dmBots/balance_robot/projects/平衡小车/结构/装配/装配说明.jpg

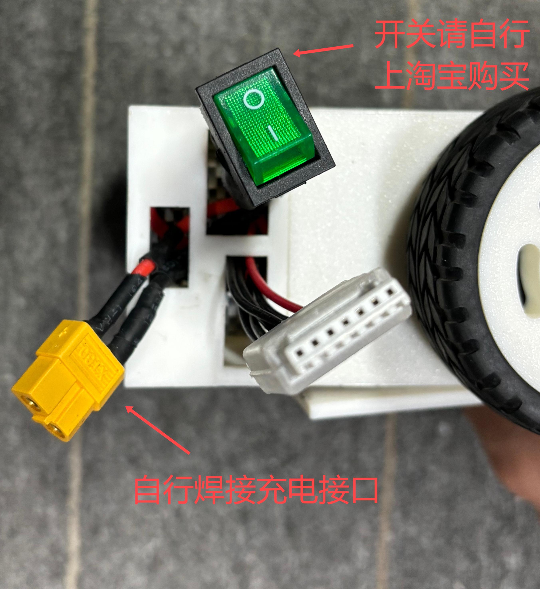
projects/平衡小车/结构/装配/装配说明.jpg
