dmBots/balance_robot/README.md

# balance_robot

English release entry. This repository is maintained from the materials source.
