dmBots/balance_robot/projects/桌面轮足/README.md

# 桌面轮足

#### 介绍
这是达妙科技开源桌面轮足仓库 QQ交流群：680048275 。

桌面轮足硬件方案是达妙STM32H7开发板+两个达妙3510电机+两个达妙3507电机+蓝牙模块。

控制模型都是是一阶倒立摆，控制方法用的是lqr。

如果该项目对您有帮助，可以点点右上角的star。

#### 软件架构

` test `

#### 安装教程

1.  xxxx
2.  xxxx
3.  xxxx

#### 使用说明

1.  xxxx
2.  xxxx
3.  xxxx

#### 参与贡献

1.  Fork 本仓库
2.  新建 Feat_xxx 分支
3.  提交代码
4.  新建 Pull Request

#### 参考

1.  [https://zhuanlan.zhihu.com/p/563048952](https://zhuanlan.zhihu.com/p/563048952)
2.  [https://www.bilibili.com/video/BV1UZ4y1h7u2/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](https://www.bilibili.com/video/BV1UZ4y1h7u2/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)
