dmBots/balance_robot/projects/平衡小车/代码/readme.txt

1、该程序是用lqr控制方法

2、参考文献来源于b站轮腿式机器人开源，连接：https://www.bilibili.com/video/BV1UZ4y1h7u2/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
