dmBots/balance_robot/projects/平衡小车/硬件接线图/平衡小车硬件接线图.png

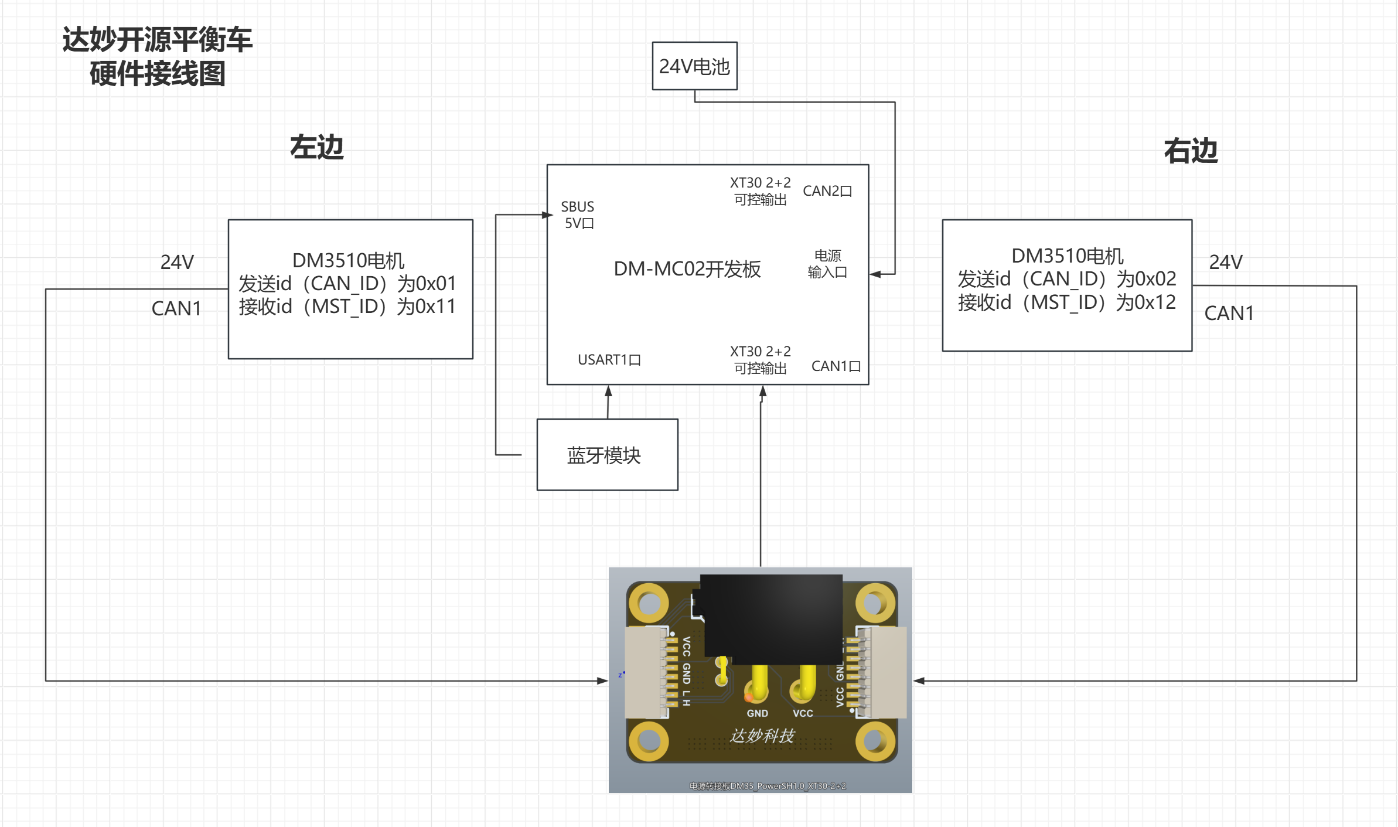
projects/平衡小车/硬件接线图/平衡小车硬件接线图.png
