dmBots/balance_robot/projects/桌面轮足/硬件接线图/达妙桌面轮足硬件接线图.png

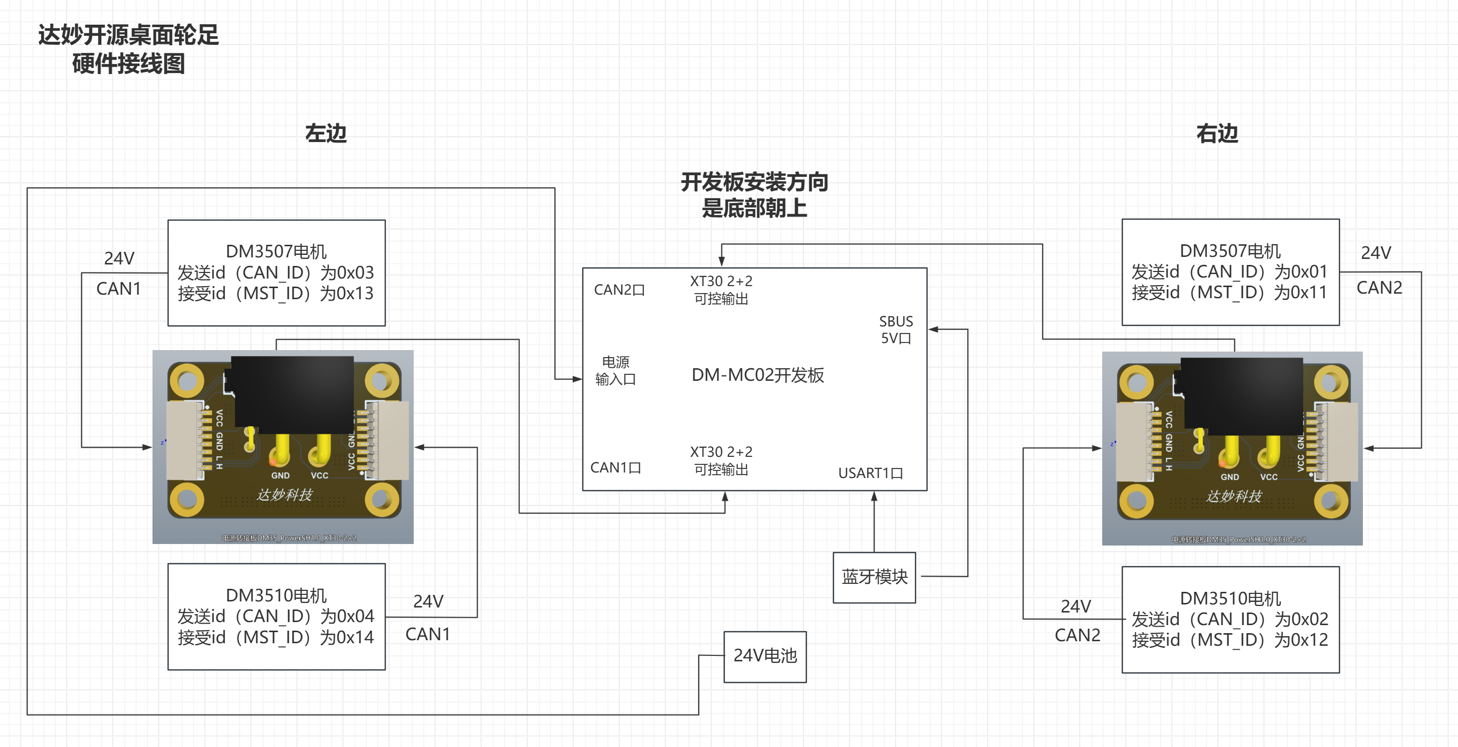
projects/桌面轮足/硬件接线图/达妙桌面轮足硬件接线图.png
