dmBots/balance_robot/projects/桌面轮足/结构/Bom gx2.17.xlsx

购买清单bom表汇总
螺钉螺母 |  |  | 数量 | 用途
沉头螺钉 | https://detail.tmall.com/item.htm?abbucket=4&id=693377485791&rn=86a33738773fb73d30a7dfbeb797c28e | M3*8 | 8 | DM-H3510-1E 固定
沉头螺钉 | https://detail.tmall.com/item.htm?abbucket=4&id=693377485791&rn=86a33738773fb73d30a7dfbeb797c28e | M3*6 | 4 | 前面板固定
沉头螺钉 | https://detail.tmall.com/item.htm?abbucket=4&id=693377485791&rn=86a33738773fb73d30a7dfbeb797c28e | M3*8 | 4 | 上面板固定
沉头螺钉 | https://detail.tmall.com/item.htm?abbucket=4&id=693377485791&rn=86a33738773fb73d30a7dfbeb797c28e | M3*12 | 4 | 限位固定
沉头螺钉 | https://detail.tmall.com/item.htm?abbucket=4&id=693377485791&rn=86a33738773fb73d30a7dfbeb797c28e | M2.5*12 | 6 | dm35_power固定，每个板装三颗 ，详见3d图示
沉头螺钉 | https://detail.tmall.com/item.htm?abbucket=4&id=693377485791&rn=86a33738773fb73d30a7dfbeb797c28e | M3*8 | 4 | 电池仓固定板固定孔
沉头螺钉 | https://detail.tmall.com/item.htm?abbucket=4&id=693377485791&rn=86a33738773fb73d30a7dfbeb797c28e | M3*12 | 6 | 左右轮轮装配
沉头螺钉 | https://detail.tmall.com/item.htm?abbucket=4&id=693377485791&rn=86a33738773fb73d30a7dfbeb797c28e | M3*12 | 6 | 左右轮轮固定
杯头螺栓 | https://detail.tmall.com/item.htm?_u=hkdjgo4a167&id=675935672539 | M3*24 | 4 | 腿左右板固定
沉头螺钉 | https://detail.tmall.com/item.htm?abbucket=4&id=693377485791&rn=86a33738773fb73d30a7dfbeb797c28e | M3*20 | 2 | 腿左右板加强螺丝
沉头螺钉 | https://detail.tmall.com/item.htm?abbucket=4&id=693377485791&rn=86a33738773fb73d30a7dfbeb797c28e | M3*16 | 6 | 大腿固定3510螺丝
对锁螺栓 | https://detail.tmall.com/item.htm?id=775683678140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 | M5*15 | 6 | 这部分固定由于对锁螺丝无法松紧适中 需自我调节螺纹胶固定
热熔螺母 | https://detail.tmall.com/item.htm?abbucket=10&id=673367228604&rn=c2a32b0ae8e4624b2e8f4e8f2e719e3e | M3*4.5*5 | 12
杯头螺栓 | https://detail.tmall.com/item.htm?abbucket=10&id=636175026159&rn=d62e44d01be55868af98aa2eff1e3e44 | M2.5*5 | 5 | 主控板固定
防松螺母 | https://detail.tmall.com/item.htm?id=534828257082&_u=12085qbuhef350 | M3 | 8
防松螺母 | https://detail.tmall.com/item.htm?id=534828257082&_u=12085qbuhef350 | M2.5 | 8
上述螺丝汇总
沉头螺钉 | https://detail.tmall.com/item.htm?abbucket=4&id=693377485791&rn=86a33738773fb73d30a7dfbeb797c28e | M3*8 | 16
沉头螺钉 | https://detail.tmall.com/item.htm?abbucket=4&id=693377485791&rn=86a33738773fb73d30a7dfbeb797c28e | M3*6 | 4
沉头螺钉 | https://detail.tmall.com/item.htm?abbucket=4&id=693377485791&rn=86a33738773fb73d30a7dfbeb797c28e | M3*12 | 16
沉头螺钉 | https://detail.tmall.com/item.htm?abbucket=4&id=693377485791&rn=86a33738773fb73d30a7dfbeb797c28e | M2.5*12 | 6
杯头螺栓 | https://detail.tmall.com/item.htm?_u=hkdjgo4a167&id=675935672539 | M3*24 | 4
沉头螺钉 | https://detail.tmall.com/item.htm?abbucket=4&id=693377485791&rn=86a33738773fb73d30a7dfbeb797c28e | M3*20 | 2
沉头螺钉 | https://detail.tmall.com/item.htm?abbucket=4&id=693377485791&rn=86a33738773fb73d30a7dfbeb797c28e | M3*16 | 6
对锁螺栓 | https://detail.tmall.com/item.htm?id=775683678140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 | M5*15 | 6
热熔螺母 | https://detail.tmall.com/item.htm?abbucket=10&id=673367228604&rn=c2a32b0ae8e4624b2e8f4e8f2e719e3e | M3*4.5*5 | 12
杯头螺栓 | https://detail.tmall.com/item.htm?abbucket=10&id=636175026159&rn=d62e44d01be55868af98aa2eff1e3e44 | M2.5*5 | 5
防松螺母 | https://detail.tmall.com/item.htm?id=534828257082&_u=12085qbuhef350 | M3 | 8
防松螺母 | https://detail.tmall.com/item.htm?id=534828257082&_u=12085qbuhef350 | M2.5 | 8
轴承
微型推力球 | https://detail.tmall.com/item.htm?id=617808114995&_u=12085qbuhe67ee&skuId=4355692940487 | F6-14M（6*14*5） | 2
法兰轴承 | https://detail.tmall.com/item.htm?_u=p2085qbuhef60e&id=619153640959&skuId=5487127778453 | MF126-ZZ[6*12*4] | 12
电机 |  |  | 数量
DM3507 | https://item.taobao.com/item.htm?id=855508643710 | —— | 2
DM-H3510-1E | —— | —— | 2
STM32 H723 | https://item.taobao.com/item.htm?id=767305853444&skuId=5440731611045 | —— | 1
电池
无参考购买链接
