dmBots/balance_robot/projects/桌面轮足/购买清单/桌面轮足Bom表.xlsx

达妙开源桌面轮足购买清单bom表汇总
螺钉螺母 |  |  | 数量 | 备注 | 图片
沉头螺钉 | https://detail.tmall.com/item.htm?id=693377485791&_u=12085qbuhe5af5 | M3*6 | 16
沉头螺钉 | https://detail.tmall.com/item.htm?id=693377485791&_u=12085qbuhe5af5 | M3*10 | 14
沉头螺钉 | https://detail.tmall.com/item.htm?id=693377485791&_u=12085qbuhe5af5 | M3*20 | 2
防松螺母 | https://detail.tmall.com/item.htm?id=534828257082&_u=12085qbuhef350 | M3 | 8
防松螺母 | https://detail.tmall.com/item.htm?id=534828257082&_u=12085qbuhef350 | M2.5 | 8
热熔螺母 | https://detail.tmall.com/item.htm?abbucket=10&id=673367228604&rn=c2a32b0ae8e4624b2e8f4e8f2e719e3e | M3*4.5*5 | 12
杯头螺栓 | https://detail.tmall.com/item.htm?abbucket=10&id=636175026159&rn=d62e44d01be55868af98aa2eff1e3e44 | M2.5*5 | 5
杯头螺栓 | https://detail.tmall.com/item.htm?abbucket=10&id=636175026159&rn=d62e44d01be55868af98aa2eff1e3e44 | M3*16 | 8
杯头螺栓 | https://detail.tmall.com/item.htm?abbucket=10&id=636175026159&rn=d62e44d01be55868af98aa2eff1e3e44 | M2.5*12 | 8
杯头螺栓 | https://detail.tmall.com/item.htm?abbucket=10&id=636175026159&rn=d62e44d01be55868af98aa2eff1e3e44 | M3*8 | 4
杯头螺栓 | https://detail.tmall.com/item.htm?abbucket=10&id=636175026159&rn=d62e44d01be55868af98aa2eff1e3e44 | M3*25 | 4
对锁螺栓 | https://detail.tmall.com/item.htm?id=775683678140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 | M5*15 | 6
轴承
微型推力球 | https://detail.tmall.com/item.htm?id=617808114995&_u=12085qbuhe67ee&skuId=4355692940487 | F6-14M（6*14*5） | 2
法兰轴承 | https://detail.tmall.com/item.htm?_u=p2085qbuhef60e&id=619153640959&skuId=5487127778453 | MF126-ZZ[6*12*4] | 12
深沟球轴承 | https://detail.tmall.com/item.htm?id=666300049176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 | 686-ZZ（6*13*5） | 4
电机 |  |  | 数量
DM3507 | https://item.taobao.com/item.htm?id=855508643710 | —— | 2
DM-H3510-1E | https://item.taobao.com/item.htm?ft=t&id=871173947758 | —— | 2
STM32 H723开发板 | https://item.taobao.com/item.htm?id=814954787248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 | —— | 1
电池 | https://item.taobao.com/item.htm?_u=b3gud67l3a33&id=527326501663&skuId=4922250528308 | 1100ma/h 30C | 1
转接板1 | https://gitee.com/kit-miao/damiao/tree/master/%E5%85%B3%E8%8A%82%E7%94%B5%E6%9C%BA/DM-J3507-2EC/%E8%BD%AC%E6%8E%A5%E6%9D%BF/SH1.0%E8%BD%ACXT30%202+2 | sh1.25-8pin转xt30 2+2 | 2 | 转接板1用于实机连线中
转接板2 | https://gitee.com/kit-miao/damiao/tree/master/%E5%85%B3%E8%8A%82%E7%94%B5%E6%9C%BA/DM-J3507-2EC/%E8%BD%AC%E6%8E%A5%E6%9D%BF/SH1.0%E8%BD%ACXT30%20+GH1.25 | sh1.25-3pin+8pin转xt30+gh1.25 | 1 | 转接板2用于上位机与电机单独调试
 | 转接板1和转接板2可以自己打板，也可以和电机一起购买（在淘宝上选好电机套餐）
蓝牙模块 | https://item.taobao.com/item.htm?_u=b2085qbuhef29d&id=618317697790&skuId=4590057118482 | JDY-33蓝牙从机模块 | 1
轮胎 | https://item.taobao.com/item.htm?_u=c2085qbuhef74b&id=587868869562&skuId=4172131990287 |  | 2
