dmBots/balance_robot/projects/桌面轮足/结构/02-Electronic Components/dm35_power_c_v1_0_asm.SLDPRT

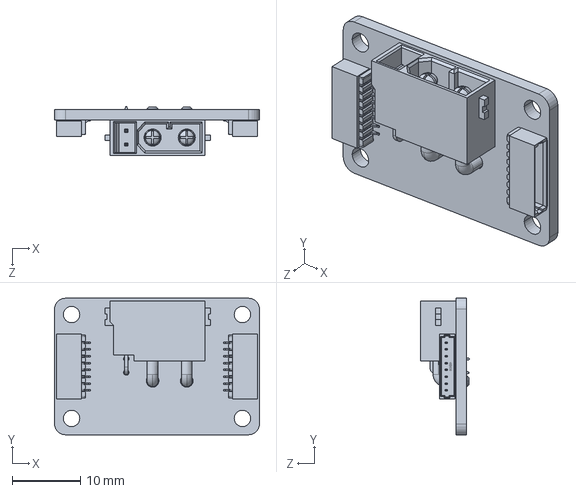
[picture p7: CAD file, 2025-01-02]
projects/桌面轮足/结构/02-Electronic Components/dm35_power_c_v1_0_asm.SLDPRT
30.0 x 20.0 x 7.12 mm
