dmBots/balance_robot/projects/桌面轮足/结构/Z03-轮装配.SLDASM

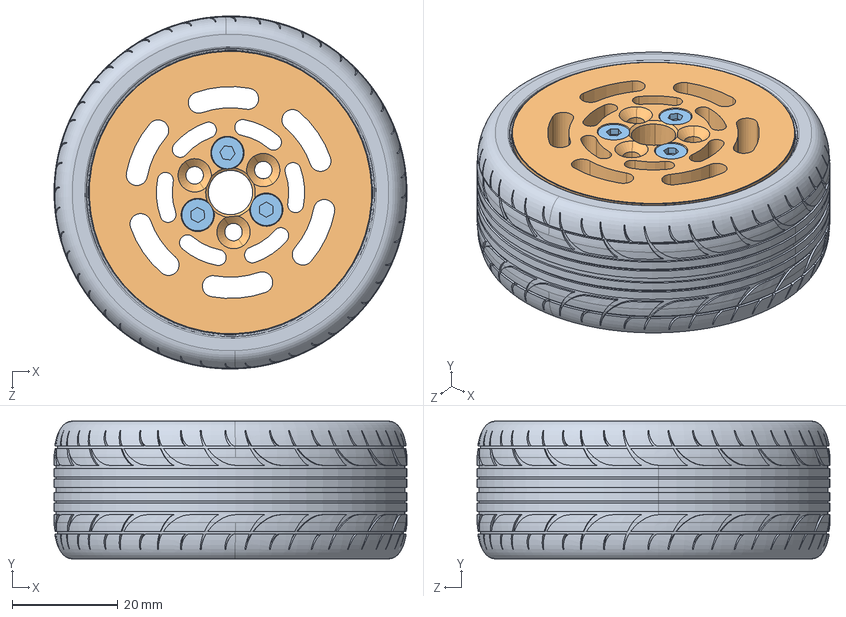
[picture p8: CAD file, 2025-01-02]
projects/桌面轮足/结构/Z03-轮装配.SLDASM
66.6 x 26.0 x 66.6 mm
001-tire
002-wheel hub
沉头螺钉 x 3
