dmBots/balance_robot/projects/桌面轮足/结构/02-Electronic Components/dm_3507_3d-241021.SLDASM

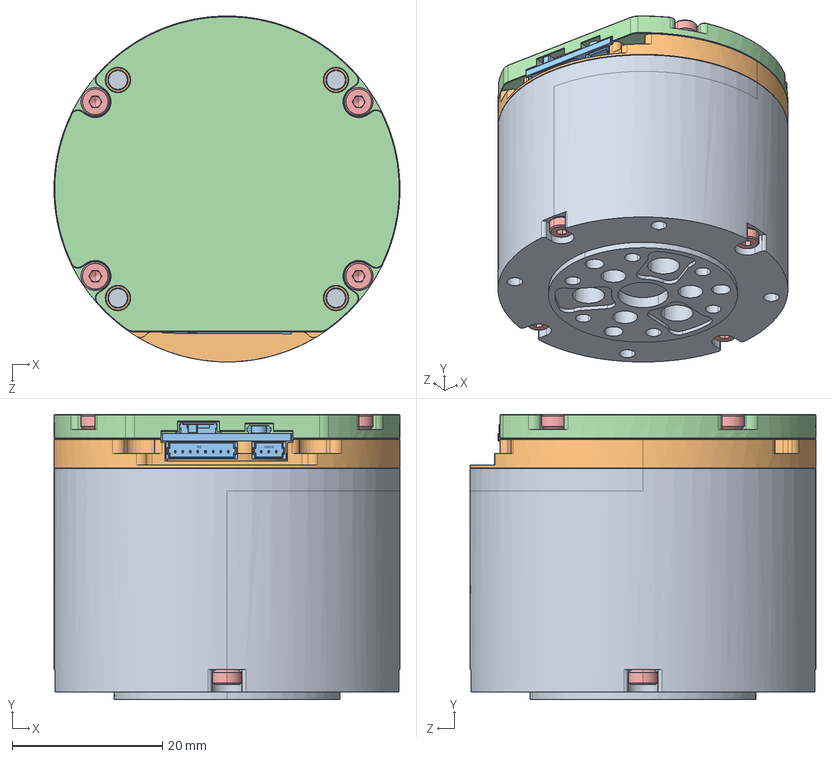
[picture p9: CAD file, 2025-01-02]
projects/桌面轮足/结构/02-Electronic Components/dm_3507_3d-241021.SLDASM
46.0 x 37.9 x 46.0 mm
3505_3D0001_D__faut.STEP
3505_00_D__faut.STEP
DM3505_V3_0-240508A_D__faut.STEP
3505_0002_D__faut.STEP
M2-5_D__faut.STEP x 8
_M2_5-60001_D__faut.STEP x 3
