dmBots/balance_robot/projects/平衡小车/结构/打印件文件/后壳.stl

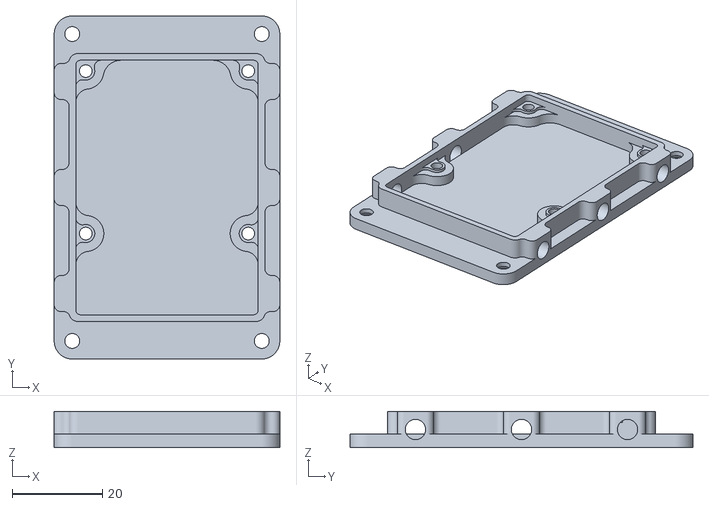
[picture p10: CAD file, 2024-11-12]
projects/平衡小车/结构/打印件文件/后壳.stl
50.0 x 76.0 x 8.00
