dmBots/balance_robot/projects/桌面轮足/结构/01-main/001-主体.SLDPRT

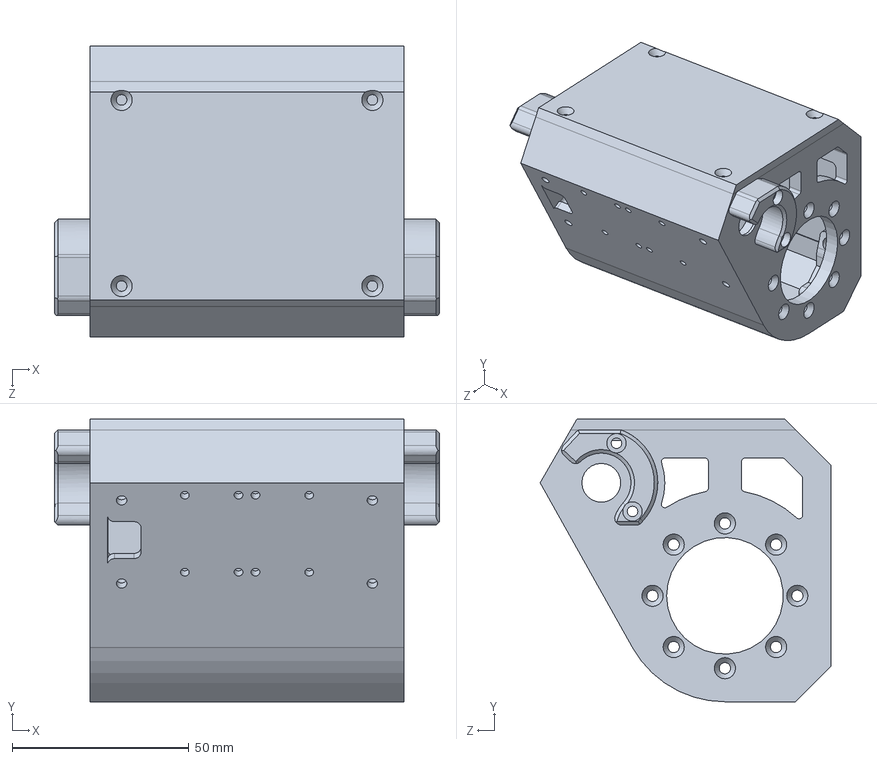
[picture p11: CAD file, 2025-01-02]
projects/桌面轮足/结构/01-main/001-主体.SLDPRT
109.0 x 80.0 x 82.3 mm
