dmBots/balance_robot/projects/桌面轮足/结构/01-main/002-电池支撑左.SLDPRT

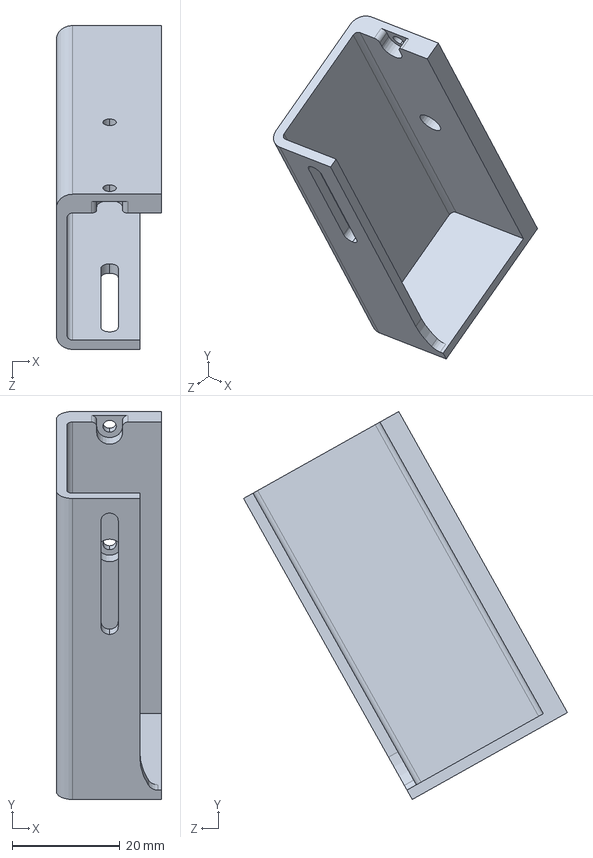
[picture p13: CAD file, 2025-01-02]
projects/桌面轮足/结构/01-main/002-电池支撑左.SLDPRT
19.6 x 72.0 x 60.1 mm
