dmBots/balance_robot/projects/平衡小车/结构/打印件文件/电机支架.stl

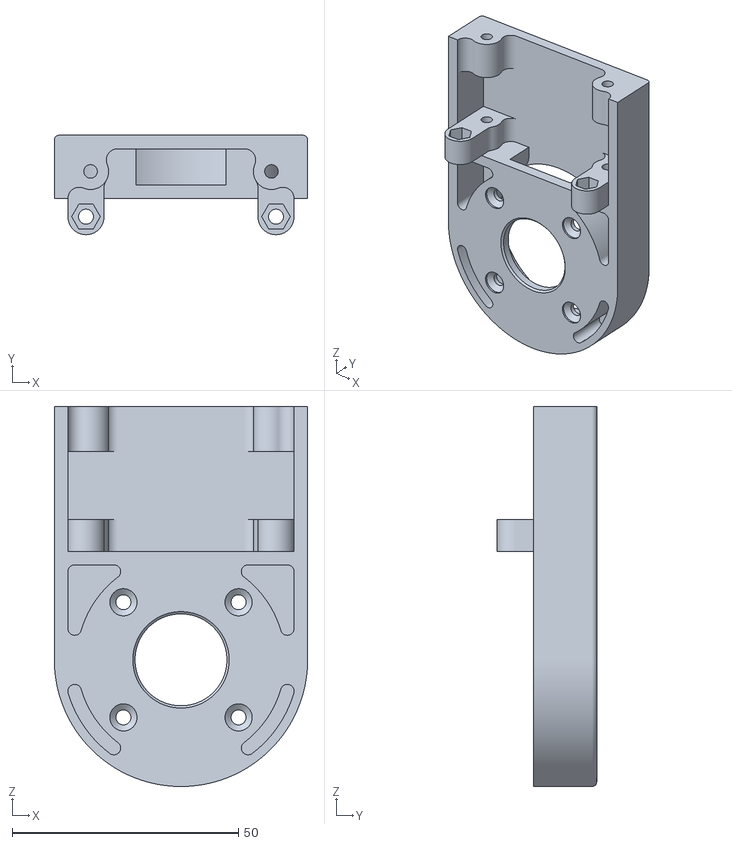
[picture p14: CAD file, 2024-11-12]
projects/平衡小车/结构/打印件文件/电机支架.stl
56.0 x 22.0 x 84.0
