dmBots/balance_robot/projects/桌面轮足/结构/04-legs/006-垫块.SLDPRT

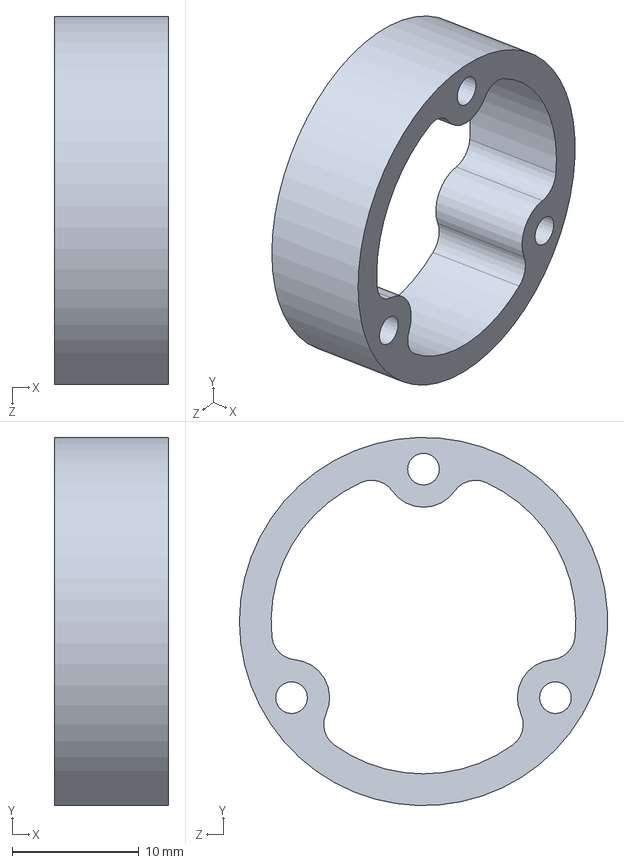
[picture p16: CAD file, 2025-01-02]
projects/桌面轮足/结构/04-legs/006-垫块.SLDPRT
9.00 x 29.0 x 29.0 mm
