dmBots/balance_robot/projects/平衡小车/结构/打印件文件/侧板1.stl

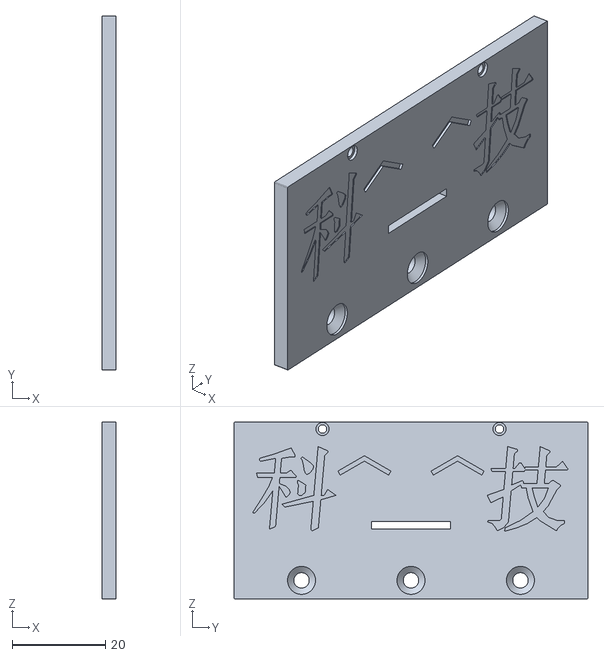
[picture p17: CAD file, 2024-11-12]
projects/平衡小车/结构/打印件文件/侧板1.stl
3.00 x 76.0 x 38.0
