dmBots/balance_robot/projects/桌面轮足/结构/04-legs/007-6-8-0.3垫片.SLDPRT

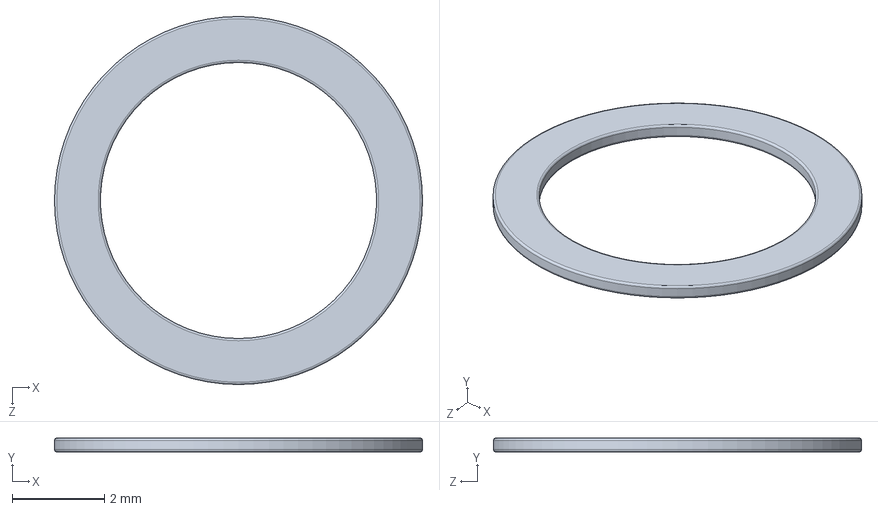
[picture p18: CAD file, 2025-01-02]
projects/桌面轮足/结构/04-legs/007-6-8-0.3垫片.SLDPRT
8.00 x 0.3 x 8.00 mm
