dmBots/balance_robot/projects/平衡小车/结构/打印件文件/顶盖.stl

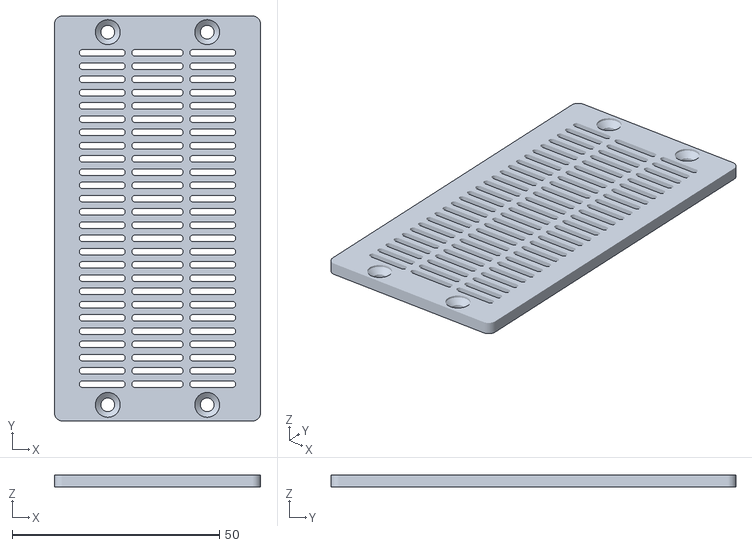
[picture p19: CAD file, 2024-11-12]
projects/平衡小车/结构/打印件文件/顶盖.stl
49.8 x 97.8 x 3.00
