dmBots/balance_robot/projects/平衡小车/结构/打印件文件/挡板.stl

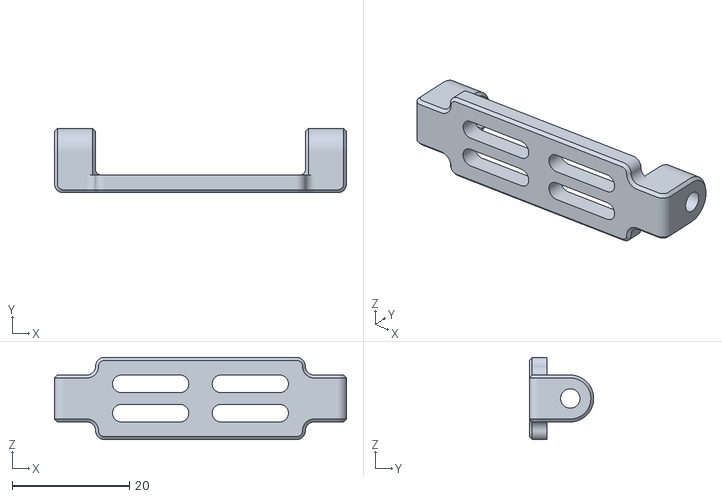
[picture p20: CAD file, 2024-11-12]
projects/平衡小车/结构/打印件文件/挡板.stl
49.8 x 11.0 x 14.0
