dmBots/balance_robot/projects/桌面轮足/结构/02-Electronic Components/6s00.SLDPRT

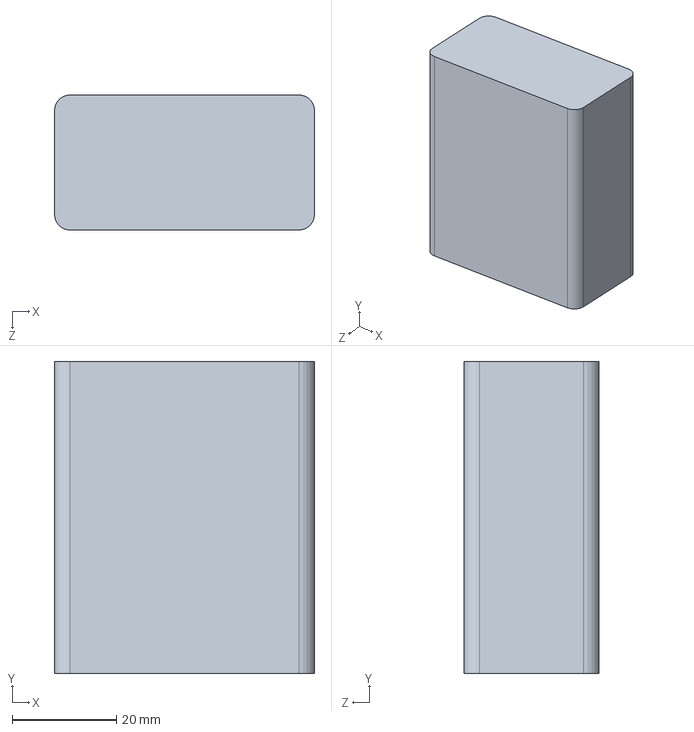
[picture p21: CAD file, 2025-01-02]
projects/桌面轮足/结构/02-Electronic Components/6s00.SLDPRT
50.0 x 60.0 x 26.0 mm
