dmBots/balance_robot/projects/桌面轮足/结构/04-legs/002-wheel hub.SLDPRT

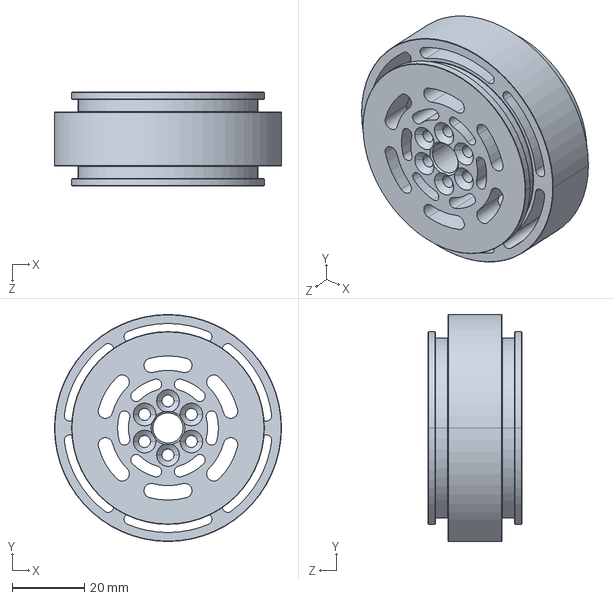
[picture p22: CAD file, 2025-01-02]
projects/桌面轮足/结构/04-legs/002-wheel hub.SLDPRT
63.0 x 63.0 x 26.0 mm
