dmBots/balance_robot/projects/平衡小车/结构/打印件文件/前壳.stl

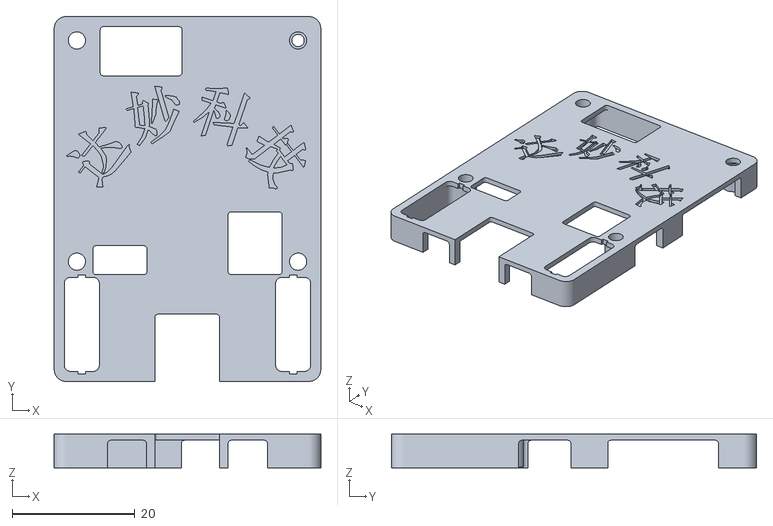
[picture p23: CAD file, 2024-11-12]
projects/平衡小车/结构/打印件文件/前壳.stl
43.4 x 59.4 x 5.50
