dmBots/balance_robot/projects/平衡小车/结构/打印件文件/压块.stl

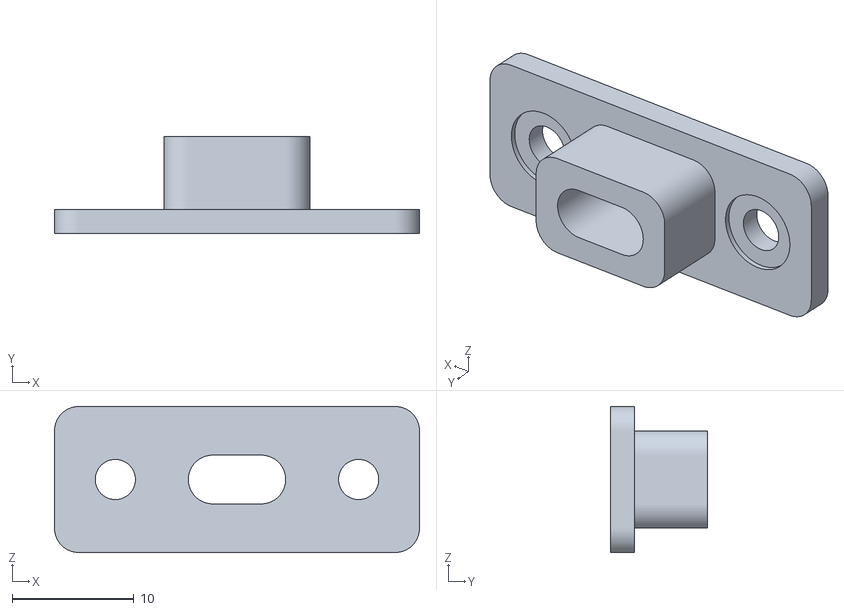
[picture p24: CAD file, 2024-11-12]
projects/平衡小车/结构/打印件文件/压块.stl
30.0 x 8.00 x 12.0
