dmBots/balance_robot/projects/平衡小车/结构/打印件文件/隔板.stl

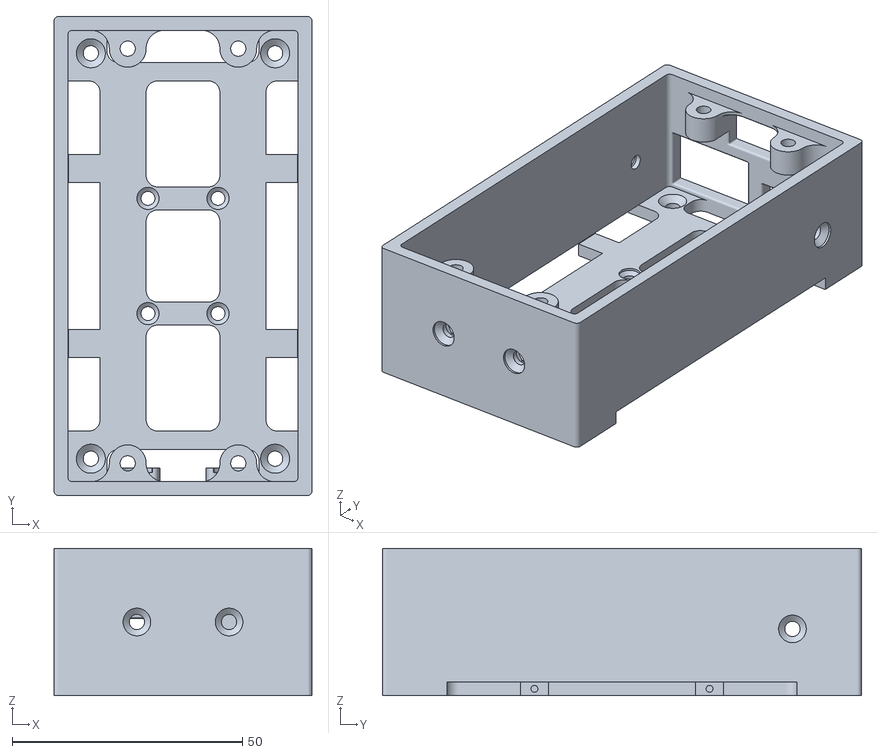
[picture p25: CAD file, 2024-11-12]
projects/平衡小车/结构/打印件文件/隔板.stl
56.0 x 104.0 x 32.0
