dmBots/balance_robot/projects/桌面轮足/结构/04-legs/007-front leg.SLDPRT

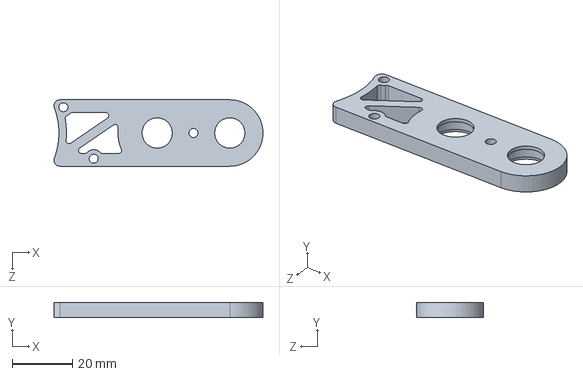
[picture p26: CAD file, 2025-01-02]
projects/桌面轮足/结构/04-legs/007-front leg.SLDPRT
69.1 x 5.00 x 22.0 mm
