dmBots/balance_robot/projects/桌面轮足/结构/04-legs/003-leg1.SLDPRT

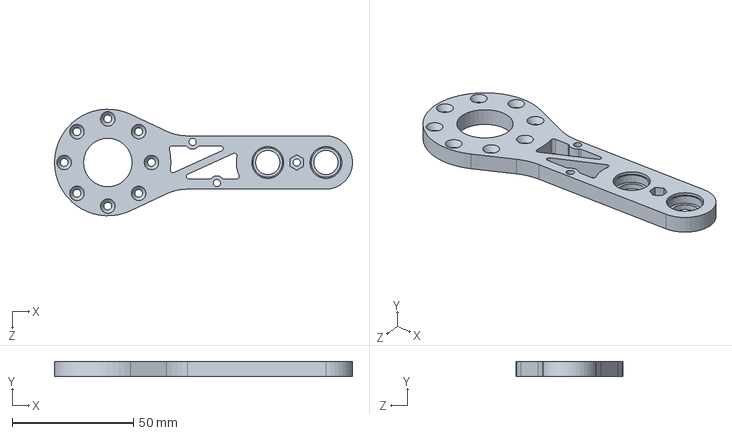
[picture p27: CAD file, 2025-01-02]
projects/桌面轮足/结构/04-legs/003-leg1.SLDPRT
123.0 x 6.00 x 44.0 mm
