dmBots/balance_robot/projects/桌面轮足/结构/04-legs/004-leg2.SLDPRT

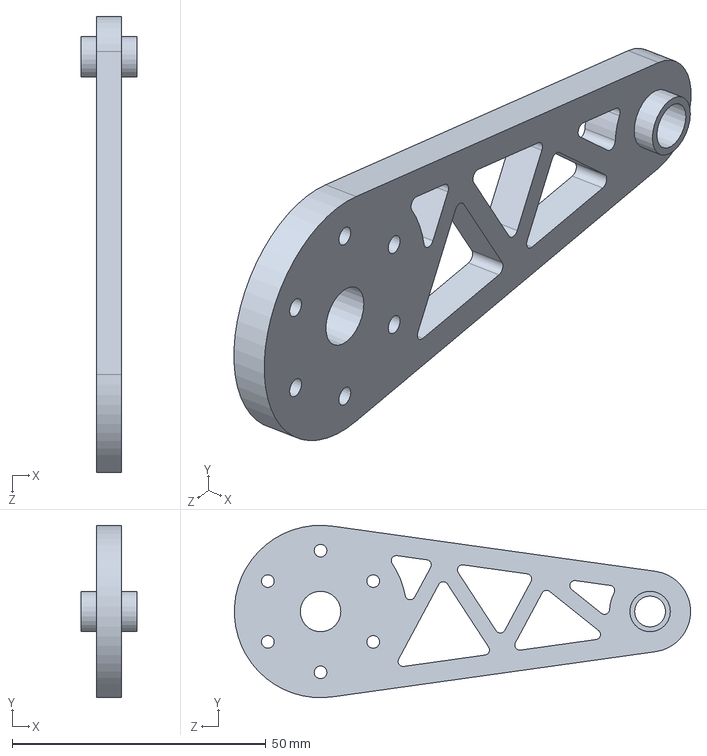
[picture p28: CAD file, 2025-01-02]
projects/桌面轮足/结构/04-legs/004-leg2.SLDPRT
11.0 x 34.0 x 89.9 mm
