dmBots/balance_robot/projects/桌面轮足/结构/04-legs/005-leg3.SLDPRT

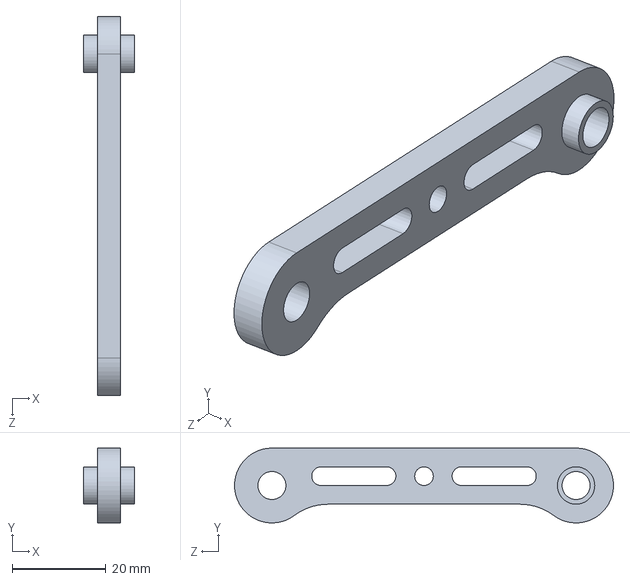
[picture p29: CAD file, 2025-01-02]
projects/桌面轮足/结构/04-legs/005-leg3.SLDPRT
11.0 x 16.0 x 81.0 mm
