dmBots/balance_robot/projects/桌面轮足/结构/04-legs/008-MF126-ZZ（6-12-4）.SLDPRT

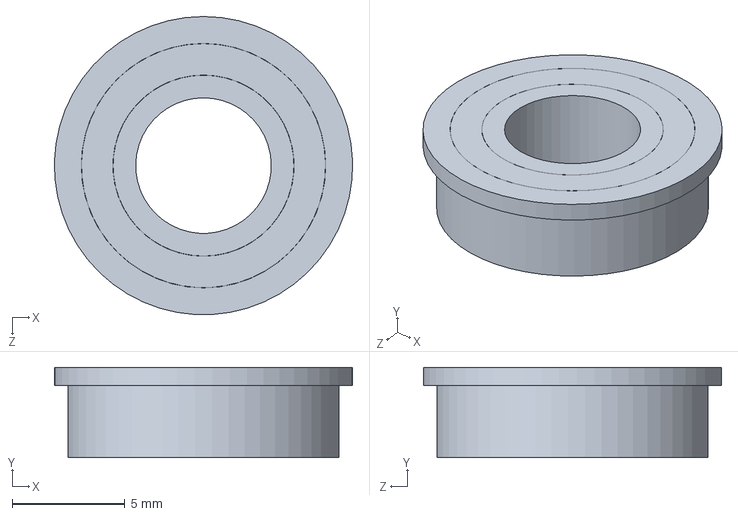
[picture p30: CAD file, 2025-01-02]
projects/桌面轮足/结构/04-legs/008-MF126-ZZ（6-12-4）.SLDPRT
13.2 x 4.00 x 13.2 mm
