dmBots/balance_robot/projects/桌面轮足/结构/04-legs/001-tire.SLDPRT

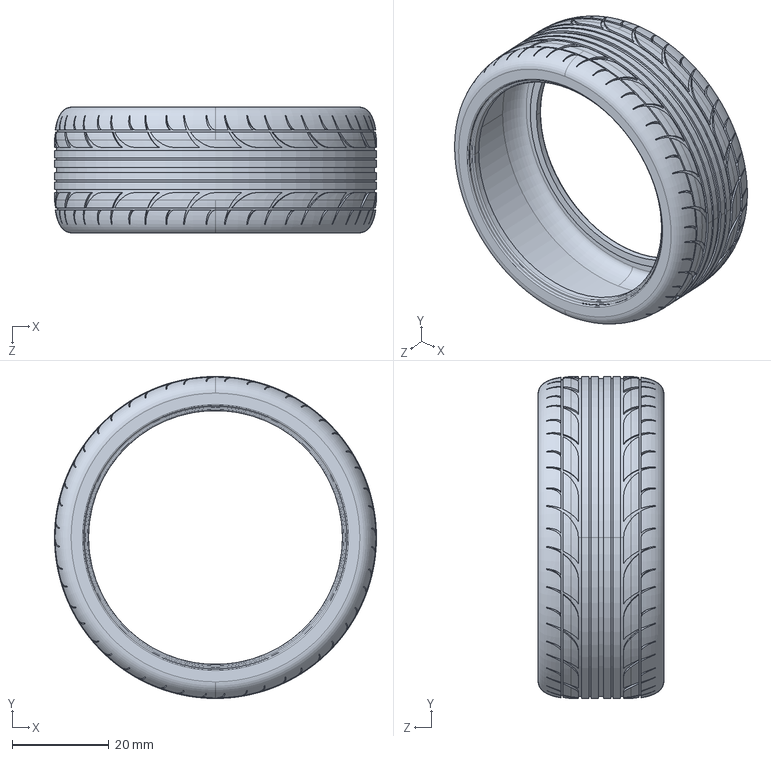
[picture p31: CAD file, 2025-01-02]
projects/桌面轮足/结构/04-legs/001-tire.SLDPRT
66.6 x 66.6 x 26.0 mm
