dmBots/balance_robot/projects/桌面轮足/结构/02-Electronic Components/Dm3510-3D.SLDASM

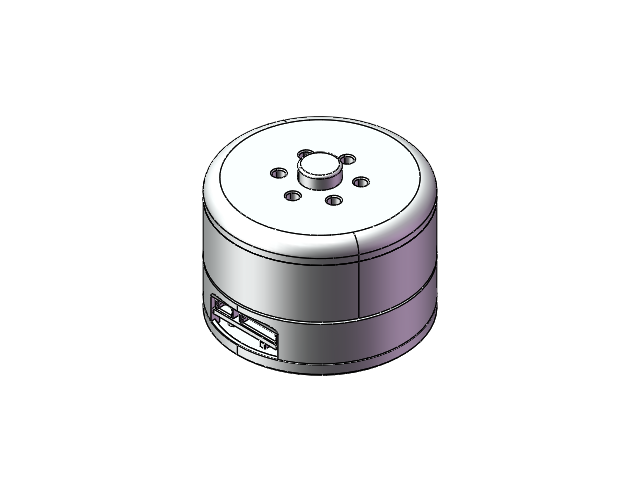
[picture p32: CAD file, 2025-01-02]
projects/桌面轮足/结构/02-Electronic Components/Dm3510-3D.SLDASM
0005^00_Dm3510-3D(2)_Dm3510-3D
6-10-300^00_Dm3510-3D(2)_Dm3510-3D x 2
0006^00_Dm3510-3D(2)_Dm3510-3D
0007^00_Dm3510-3D(2)_Dm3510-3D
000^Dm3510-3D(2)_Dm3510-3D
000-0^Dm3510-3D(2)_Dm3510-3D
00-1^Dm3510-3D(2)_Dm3510-3D
DM3510_V3_0-240821B^Dm3510-3D(2)_Dm3510-3D
TAL06-M2-L4^Dm3510-3D(2)_Dm3510-3D x 2
0008^Dm3510-3D(2)_Dm3510-3D
TAU32-M2-L600^Dm3510-3D(2)_Dm3510-3D x 3
