dmBots/balance_robot/(list of files, cad)

Other CAD files:
projects/平衡小车/结构/平衡车开源结构/挡板.sldasm
projects/桌面轮足/结构/02-Electronic Components/镜向Dm3510-3D.SLDASM
projects/桌面轮足/结构/镜向Z03-轮装配.SLDASM
projects/桌面轮足/结构/02-Electronic Components/镜向Dm3510-3D1.SLDASM
projects/桌面轮足/结构/镜向Z02-腿装配.SLDASM
projects/桌面轮足/结构/02-Electronic Components/dm_3505_3d.SLDASM
projects/平衡小车/结构/平衡车开源结构/电池盒-主体.sldasm
projects/平衡小车/结构/平衡车开源结构/顶盖.sldasm
projects/平衡小车/结构/平衡车开源结构/驱动轮.sldasm
projects/平衡小车/结构/平衡车开源结构/车身主体.sldasm
projects/平衡小车/结构/平衡车开源结构/壳子.sldasm
projects/平衡小车/结构/平衡车开源结构/电池盒.sldasm
projects/平衡小车/结构/平衡车开源结构/0-平衡车.sldasm
projects/平衡小车/结构/平衡车开源结构/电机-板.sldasm
projects/平衡小车/结构/0-平衡车.stp
projects/桌面轮足/结构/04-legs/镜向002-wheel hub.SLDPRT
projects/桌面轮足/结构/Z04-总装配.STEP
projects/桌面轮足/结构/04-legs/镜向007-front leg.SLDPRT
projects/平衡小车/结构/平衡车开源结构/m3螺母.sldprt
projects/平衡小车/结构/平衡车开源结构/沉头螺丝-m2_5-10.sldprt
projects/桌面轮足/结构/04-legs/镜向004-leg2.SLDPRT
projects/平衡小车/结构/平衡车开源结构/圆柱螺母-m3_6.sldprt
projects/桌面轮足/结构/04-legs/镜向005-leg3.SLDPRT
projects/桌面轮足/结构/04-legs/镜向006-垫块.SLDPRT
projects/桌面轮足/结构/04-legs/镜向003-leg1.SLDPRT
projects/平衡小车/结构/平衡车开源结构/电池6s.sldprt
projects/平衡小车/结构/打印件文件/轮毂.stl
projects/平衡小车/结构/平衡车开源结构/挠性压簧-0_8-8-15_af1.sldprt
projects/平衡小车/结构/平衡车开源结构/后壳.sldprt
projects/平衡小车/结构/平衡车开源结构/沉头螺丝-m3_6.sldprt
projects/桌面轮足/结构/04-legs/镜向008-MF126-ZZ（6-12-4）.SLDPRT
projects/平衡小车/结构/平衡车开源结构/dm3510-轮毂电机.sldprt
projects/平衡小车/结构/平衡车开源结构/电机支架.sldprt
projects/桌面轮足/结构/04-legs/镜向001-tire.SLDPRT
projects/平衡小车/结构/平衡车开源结构/沉头螺丝-m3_10.sldprt
projects/平衡小车/结构/平衡车开源结构/轮胎.sldprt
projects/平衡小车/结构/平衡车开源结构/轮毂.sldprt
projects/平衡小车/结构/平衡车开源结构/侧板.sldprt
projects/平衡小车/结构/平衡车开源结构/jdy-33蓝牙模块.sldprt
projects/平衡小车/结构/平衡车开源结构/沉头螺丝-m3_12.sldprt
projects/平衡小车/结构/平衡车开源结构/隔板.sldprt
projects/平衡小车/结构/平衡车开源结构/挠性压簧-0_8-8-15_af0.sldprt
projects/平衡小车/结构/平衡车开源结构/压块.sldprt
projects/平衡小车/结构/平衡车开源结构/侧板1.sldprt
projects/平衡小车/结构/平衡车开源结构/前壳.sldprt
projects/平衡小车/结构/平衡车开源结构/驱动板.sldprt
projects/平衡小车/结构/平衡车开源结构/m2_5螺母.sldprt
projects/平衡小车/结构/平衡车开源结构/m3-4-4_5_土八注塑铜螺母.sldprt
projects/平衡小车/结构/平衡车开源结构/挡板.sldprt
projects/平衡小车/结构/平衡车开源结构/顶盖.sldprt
projects/桌面轮足/结构/03-Screws and Bolts/13-6-5轴承.SLDPRT
projects/桌面轮足/结构/03-Screws and Bolts/304不锈钢倒边内六角对锁螺丝-2.SLDPRT
projects/桌面轮足/结构/03-Screws and Bolts/304不锈钢倒边内六角对锁螺丝.SLDPRT
projects/桌面轮足/结构/03-Screws and Bolts/304不锈钢倒边内六角对锁螺丝2-对边.SLDPRT
projects/桌面轮足/结构/03-Screws and Bolts/5-3.2-14隔离柱.SLDPRT
projects/桌面轮足/结构/03-Screws and Bolts/6-10-3垫片.SLDPRT
projects/桌面轮足/结构/03-Screws and Bolts/6-13-5 深沟球微型轴承.SLDPRT
projects/桌面轮足/结构/03-Screws and Bolts/M3-4-4.5 土八注塑铜螺母镶件.SLDPRT
projects/桌面轮足/结构/03-Screws and Bolts/推力球轴承 6-14-5.SLDPRT
projects/桌面轮足/结构/03-Screws and Bolts/杯头螺钉.SLDPRT
projects/桌面轮足/结构/03-Screws and Bolts/沉头螺钉.SLDPRT
projects/桌面轮足/结构/03-Screws and Bolts/镜向304不锈钢倒边内六角对锁螺丝-2.SLDPRT
projects/桌面轮足/结构/03-Screws and Bolts/镜向304不锈钢倒边内六角对锁螺丝2-对边.SLDPRT
projects/桌面轮足/结构/03-Screws and Bolts/镜向5-3.2-14隔离柱.SLDPRT
projects/桌面轮足/结构/03-Screws and Bolts/镜向6-13-5 深沟球微型轴承.SLDPRT
projects/桌面轮足/结构/03-Screws and Bolts/镜向推力球轴承 6-14-5.SLDPRT
projects/桌面轮足/结构/03-Screws and Bolts/镜向杯头螺钉.SLDPRT
projects/桌面轮足/结构/03-Screws and Bolts/镜向沉头螺钉.SLDPRT
projects/桌面轮足/结构/03-Screws and Bolts/镜向防松螺母.SLDPRT
projects/桌面轮足/结构/03-Screws and Bolts/防松螺母.SLDPRT
