dmBots/balance_robot/(list of files, drawings)

Other design files:
projects/平衡小车/转接板文件/DM35_Power_C_V1.0.SchDoc
projects/平衡小车/转接板文件/DM35_Power_C_V2.0.PcbDoc
projects/桌面轮足/转接板文件/DM35_Power_C_V1.0.SchDoc
projects/桌面轮足/转接板文件/DM35_Power_C_V2.0.PcbDoc
