dmBots/balance_robot/projects/桌面轮足/代码/DM-legged_car2025_1_10/Core/Src/main.c

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
/* Includes ------------------------------------------------------------------*/
#include "main.h"
#include "cmsis_os.h"
#include "dma.h"
#include "fdcan.h"
#include "memorymap.h"
#include "spi.h"
#include "tim.h"
#include "usart.h"
#include "usb_device.h"
#include "gpio.h"

/* USER CODE BEGIN Includes */
#include "BMI088driver.h"
#include "kalman_filter.h"
#include "mahony_filter.h"
#include "bsp_dwt.h"
#include "BMI088Middleware.h"
#include "can_bsp.h"
#include "bsp_usart1.h"
/* USER CODE END Includes */

/* USER CODE BEGIN PTD */
extern rev_data_t rev_data;
/* USER CODE END PTD */


void SystemClock_Config(void);
void PeriphCommonClock_Config(void);
void MX_FREERTOS_Init(void);
/**
  * @brief  The application entry point.
  * @retval int
  */
int main(void)
{

  /* MCU Configuration--------------------------------------------------------*/

  /* Reset of all peripherals, Initializes the Flash interface and the Systick. */
  HAL_Init();

  /* USER CODE BEGIN Init */
//06 01 00 00 00 00 00 00 00 00 00 00 00 00 80 3F
  /* USER CODE END Init */

  /* Configure the system clock */
  SystemClock_Config();

  /* Configure the peripherals common clocks */
  PeriphCommonClock_Config();

  /* Initialize all configured peripherals */
  MX_GPIO_Init();
  MX_DMA_Init();
  MX_SPI2_Init();
  MX_FDCAN1_Init();
  MX_FDCAN2_Init();
  MX_TIM3_Init();
  MX_FDCAN3_Init();
  MX_USART1_UART_Init();
  /* USER CODE BEGIN 2 */
	DWT_Init(480);
  
    /* BMI088初始化 */
  while (BMI088_init(&hspi2, 0) != BMI088_NO_ERROR)
	{
	  ;
	}
	
	
  HAL_UART_Receive_IT(&huart1,rev_data.rx, 8);//接收
	
	Power_OUT1_ON;//imu初始化完成，可控电源打开，led灯亮
	Power_OUT2_ON;
	
  FDCAN1_Config();//can过滤器初始化
	FDCAN2_Config();
  /* USER CODE END 2 */

  /* Call init function for freertos objects (in cmsis_os2.c) */
  MX_FREERTOS_Init();

  /* Start scheduler */
  osKernelStart();

  /* We should never get here as control is now taken by the scheduler */

  /* Infinite loop */
  /* USER CODE BEGIN WHILE */
  while (1)
  {
    /* USER CODE END WHILE */

    /* USER CODE BEGIN 3 */
 
  }
  /* USER CODE END 3 */
}

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
/**
  * @brief  Period elapsed callback in non blocking mode
  * @note   This function is called  when TIM2 interrupt took place, inside
  * HAL_TIM_IRQHandler(). It makes a direct call to HAL_IncTick() to increment
  * a global variable "uwTick" used as application time base.
  * @param  htim : TIM handle
  * @retval None
  */
void HAL_TIM_PeriodElapsedCallback(TIM_HandleTypeDef *htim)
{
  if (htim->Instance == TIM2) {
    HAL_IncTick();
  }
}

/**
  * @brief  This function is executed in case of error occurrence.
  * @retval None
  */
void Error_Handler(void)
{
  /* USER CODE BEGIN Error_Handler_Debug */
  /* User can add his own implementation to report the HAL error return state */
  __disable_irq();
  while (1)
  {
  }
  /* USER CODE END Error_Handler_Debug */
}

#ifdef  USE_FULL_ASSERT
/**
  * @brief  Reports the name of the source file and the source line number
  *         where the assert_param error has occurred.
  * @param  file: pointer to the source file name
  * @param  line: assert_param error line source number
  * @retval None
  */
void assert_failed(uint8_t *file, uint32_t line)
{
  /* USER CODE BEGIN 6 */
  /* User can add his own implementation to report the file name and line number,
     ex: printf("Wrong parameters value: file %s on line %d\r\n", file, line) */
  /* USER CODE END 6 */
}
#endif /* USE_FULL_ASSERT */
