dmBots/balance_robot/projects/桌面轮足/代码/DM-legged_car2025_1_10/CtrlBoard-H7_IMU.ioc

Mcu.UserName=STM32H723VGTx
PA0.GPIO_Label=DI
PA0.Signal=GPIO_Input
PA10.Signal=USART1_RX
PA11.Signal=USB_OTG_HS_DM
PA12.Signal=USB_OTG_HS_DP
PA13(JTMS/SWDIO).Signal=DEBUG_JTMS-SWDIO
PA14(JTCK/SWCLK).Signal=DEBUG_JTCK-SWCLK
PA2.GPIO_Label=DO
PA2.Signal=GPIO_Output
PA9.Signal=USART1_TX
PB1.Signal=S_TIM3_CH4
PB13.Signal=SPI2_SCK
PB5.Signal=FDCAN2_RX
PB6.Signal=FDCAN2_TX
PC0.GPIO_Label=ACC_CS
PC0.Signal=GPIO_Output
PC1.Signal=SPI2_MOSI
PC13.Signal=GPIO_Output
PC14-OSC32_IN.Signal=GPIO_Output
PC2_C.Signal=SPI2_MISO
PC3_C.GPIO_Label=GYRO_CS
PC3_C.Signal=GPIO_Output
PD0.Signal=FDCAN1_RX
PD1.Signal=FDCAN1_TX
PD12.Signal=FDCAN3_RX
PD13.Signal=FDCAN3_TX
PE10.GPIO_Label=ACC_INT
PE10.Signal=GPXTI10
PE12.GPIO_Label=GYRO_INT
PE12.Signal=GPXTI12
PE13.GPIO_Label=CLK
PE13.Signal=GPIO_Output
PE9.GPIO_Label=CS
PE9.Signal=GPIO_Output
PH0-OSC_IN.Signal=RCC_OSC_IN
PH1-OSC_OUT.Signal=RCC_OSC_OUT
