dmBots/balance_robot/projects/桌面轮足/代码/DM-legged_car2025_1_10/User/Bsp/bsp_vofa.c

#include "bsp_vofa.h"
#include "usbd_cdc_if.h"
#include "usbd_core.h"
#include "usbd_cdc.h"
#include "chassisR_task.h"
#define MAX_BUFFER_SIZE 1024
uint8_t send_buf[MAX_BUFFER_SIZE];
uint16_t cnt = 0;

extern chassis_t chassis_move;

/**
***********************************************************************
* @brief:      vofa_start(void)
* @param:		   void
* @retval:     void
* @details:    发送数据给上位机
***********************************************************************
**/
void vofa_start(void)
{
	vofa_demo();		// demo示例
}

/**
***********************************************************************
* @brief:      vofa_transmit(uint8_t* buf, uint16_t len)
* @param:		void
* @retval:     void
* @details:    修改通信工具，USART或者USB
***********************************************************************
**/
void vofa_transmit(uint8_t* buf, uint16_t len)
{
	CDC_Transmit_HS((uint8_t *)buf, len);
}
/**
***********************************************************************
* @brief:      vofa_send_data(float data)
* @param[in]:  num: 数据编号 data: 数据 
* @retval:     void
* @details:    将浮点数据拆分成单字节
***********************************************************************
**/
void vofa_send_data(uint8_t num, float data) 
{
	send_buf[cnt++] = byte0(data);
	send_buf[cnt++] = byte1(data);
	send_buf[cnt++] = byte2(data);
	send_buf[cnt++] = byte3(data);
}
/**
***********************************************************************
* @brief      vofa_sendframetail(void)
* @param      NULL 
* @retval     void
* @details:   给数据包发送帧尾
***********************************************************************
**/
void vofa_sendframetail(void) 
{
	send_buf[cnt++] = 0x00;
	send_buf[cnt++] = 0x00;
	send_buf[cnt++] = 0x80;
	send_buf[cnt++] = 0x7f;
	
	/* 将数据和帧尾打包发送 */
	vofa_transmit((uint8_t *)send_buf, cnt);
	cnt = 0;// 每次发送完帧尾都需要清零
}
/**
***********************************************************************
* @brief      vofa_demo(void)
* @param      NULL 
* @retval     void
* @details:   demo示例
***********************************************************************
**/
void vofa_demo(void) 
{

	// Call the function to store the data in the buffer
	vofa_send_data(0, chassis_move.v);
	vofa_send_data(1, chassis_move.v_act);
	vofa_send_data(2, chassis_move.v_set);
	vofa_send_data(3, chassis_move.x);
	vofa_send_data(4, chassis_move.x_set);
	vofa_send_data(5, 0.0f);
	vofa_send_data(6, 0.0f);
	// Call the function to send the frame tail
	vofa_sendframetail();
}
