dmBots/balance_robot/(commit log)

2024-11-11 上传第一次程序
2024-11-12 第一次上传结构部分
    [0-平衡车.sldasm, dm3510-轮毂电机.sldprt, jdy-33蓝牙模块.sldprt, m2_5螺母.sldprt, m3-4-4_5_土八注塑铜螺母.sldprt, m3螺母.sldprt, 侧板.sldprt, 侧板1.sldprt]
2024-11-30 添加硬件接线图
2024-11-30 添加一些文件说明
2024-12-25 更新了一些说明
2024-12-25 修改了一些文件说明
2024-12-31 新增桌面轮足资料
    [0-平衡车.sldasm, 001-tire.SLDPRT, 001-主体.SLDPRT, 002-wheel hub.SLDPRT, 002-电池支撑右.SLDPRT, 002-电池支撑左.SLDPRT, 003-leg1.SLDPRT, 004-leg2.SLDPRT]
2025-01-02 更新结构文件
    [001-主体.SLDPRT, Bom.xlsx, 镜向002-wheel hub.SLDPRT, 镜向Z02-腿装配.SLDASM, 镜向Z03-轮装配.SLDASM, 镜向杯头螺钉.SLDPRT]
2025-01-02 修改了一些文件名
    [0-平衡车.sldasm, 001-tire.SLDPRT, 001-主体.SLDPRT, 002-wheel hub.SLDPRT, 002-电池支撑右.SLDPRT, 002-电池支撑左.SLDPRT, 003-leg1.SLDPRT, 004-leg2.SLDPRT]
2025-01-02 在readme文件里添加了一些说明
2025-01-02 在readme里修改了些说明
2025-01-02 删除了一些多余的文件
2025-01-03 添加蓝牙遥控工程建立教学视频和桌面轮足转接板打板文件
2025-01-03 添加转接板链接
2025-01-03 更新硬件接线图以及上传了转接板链接
2025-01-03 上传平衡车的lqr调参文件
2025-01-04 上传桌面轮足和平衡小车的bom表
    [Bom.xlsx, 桌面轮足Bom表.xlsx]
2025-01-09 原来的平衡小车程序的电机方向反了，现在调整完成
    [桌面轮足Bom表.xlsx]
2025-01-10 原来的桌面轮足程序的电机正负方向反了，现在已经调整改好
2025-02-11 上传sh1.0转xt30 2+2转接板
    [DM35_Power_C_V1.0.SchDoc, DM35_Power_C_V2.0.PcbDoc]
2026-06-30 chore: sync public materials from governed source
