dmBots/balance_robot/(notices)

Notices in the files:
projects/桌面轮足/代码/DM-legged_car2025_1_10/Core/Src/main.c:
Copyright (c) 2024 STMicroelectronics.
All rights reserved.
This software is licensed under terms that can be found in the LICENSE file
